aaron02/TEAM5_DOUG/Controller/readme.md

# Controller

## Links

Text to MP3: https://voicegenerator.io/
