aaron02/TEAM5_DOUG/Controller/HW/Render/3d.png

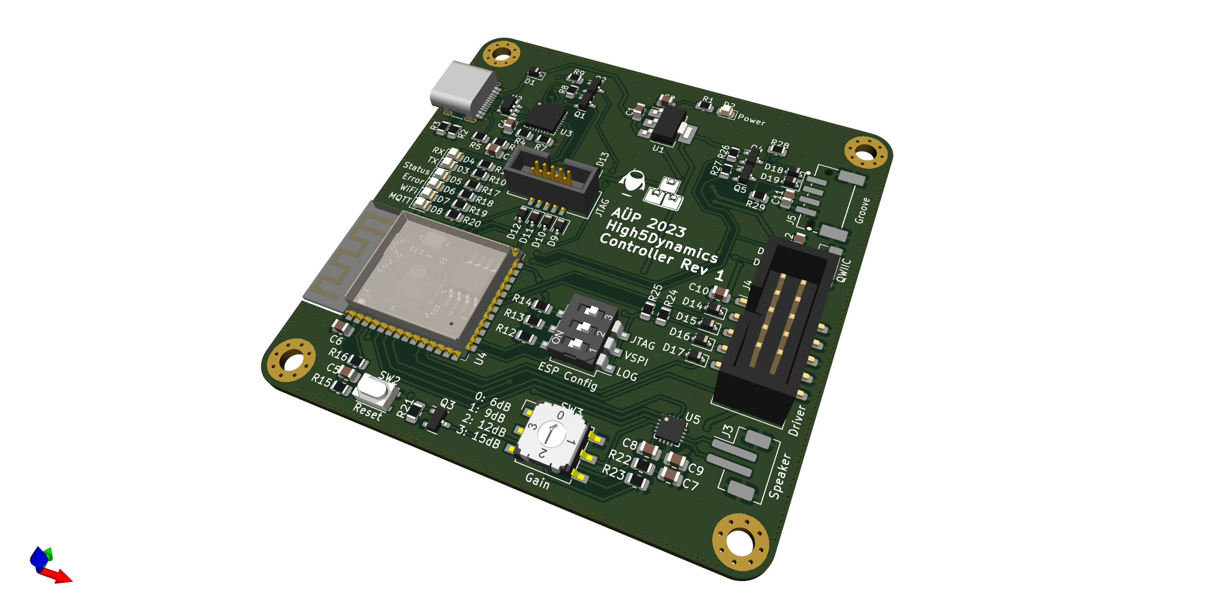
Controller/HW/Render/3d.png
