aaron02/TEAM5_DOUG/Controller/HW/Render/Render.png

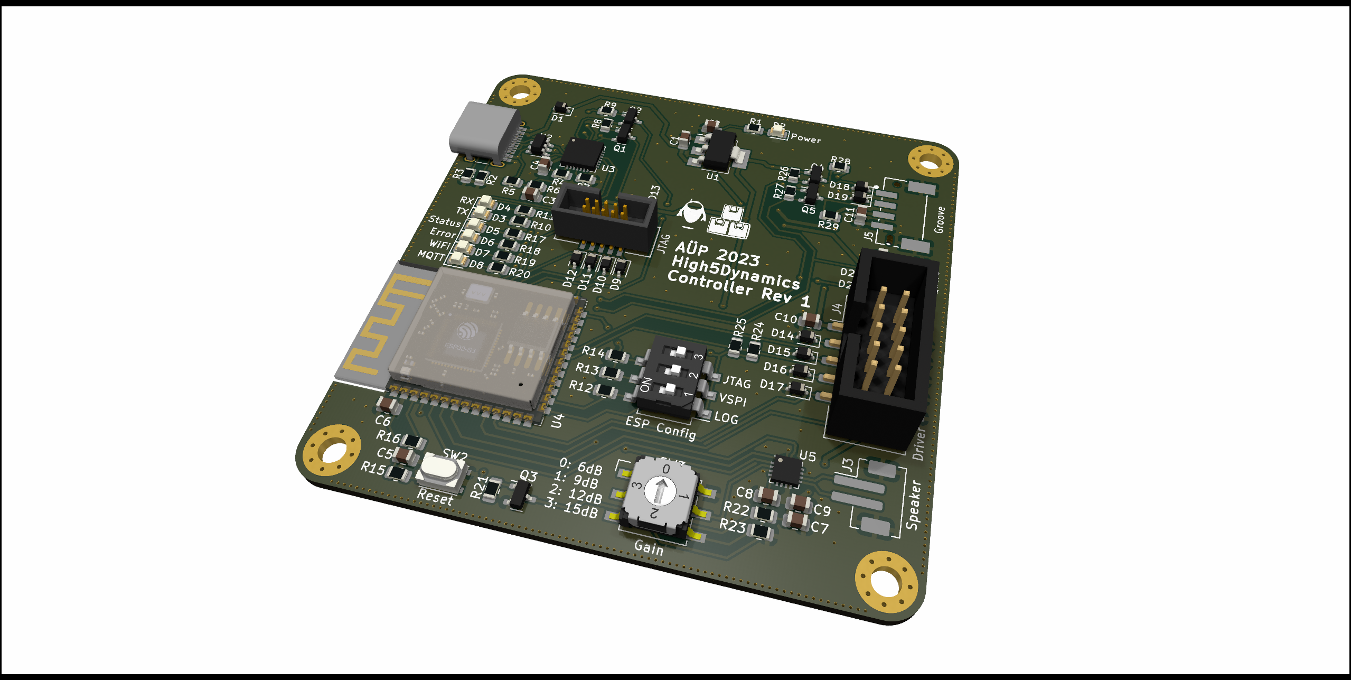
Controller/HW/Render/Render.png
