aaron02/TEAM5_DOUG/Controller/HW/BOM/BOM.xlsx

Reference | Value | DigiKey | Qty
J1 | USB |  | 1
SW2 | Reset |  | 1
J4 | Driver | 1175-1621-ND | 1
J2 | JTAG | 1175-1629-ND | 1
C5 | 1u | 1276-1026-1-ND | 1
C1, C2, C4, C6, C7 | 10u | 1276-1096-1-ND | 5
C3, C8-C12 | 100n | 1276-2449-1-ND | 6
Q4, Q5 | NX138AK | 1727-2731-1-ND | 2
Q1-Q3 | MMBT3904 | 1727-4044-1-ND | 3
U4 | ESP32-S3-WROOM-1 | 1965-ESP32-S3-WROOM-1-N8CT-ND | 1
SW1 | ESP Config | 2223-DS04-254-2-03BK-SMT-ND | 1
R6 | 47.5k | 311-47.5KCRCT-ND | 1
U3 | CP2102N-Axx-xQFN28 | 336-5890-1-ND | 1
J6 | QWIIC | 455-1790-1-ND | 1
J5 | Groove | 455-2639-1-ND | 1
J3 | Speaker | 455-2872-1-ND | 1
D6 | Error | 475-1278-1-ND | 1
D3 | TX | 475-1410-1-ND | 1
D4 | RX | 475-1410-1-ND | 1
D5 | Status | 475-1410-1-ND | 1
D7 | WiFi | 475-1410-1-ND | 1
D8 | MQTT | 475-1410-1-ND | 1
D2 | Power | 475-2488-1-ND | 1
U2 | USBLC6-2SC6 | 497-5235-1-ND | 1
SW3 | Gain | 563-1217-1-ND | 1
U1 | AP1117-33 | AZ1117IH-3.3TRG1DICT-ND | 1
R1, R4, R10, R11, R15, R17-R20 | 1k | CR0805-FX-1001ELFCT-ND | 9
R7-R9, R12-R14, R16, R21, R22, R24-R29 | 10k | CR0805-FX-1002ELFCT-ND | 15
R23 | 100k | CR0805-FX-1003ELFCT-ND | 1
R5 | 22.1k | CR0805-FX-2212ELFCT-ND | 1
R2, R3 | 5.1k | CR0805-FX-5101ELFCT-ND | 2
D9-D12, D14-D21 | D1213A | D1213A-01WS-7DICT-ND | 12
U5 | MAX98357A | MAX98357AETE+TCT-ND | 1
D1, D13 | NSR0320 | NSR0320MW2T3GOSCT-ND | 2
