aaron02/TEAM5_DOUG/Driver/HW/PDF/Driver.pdf

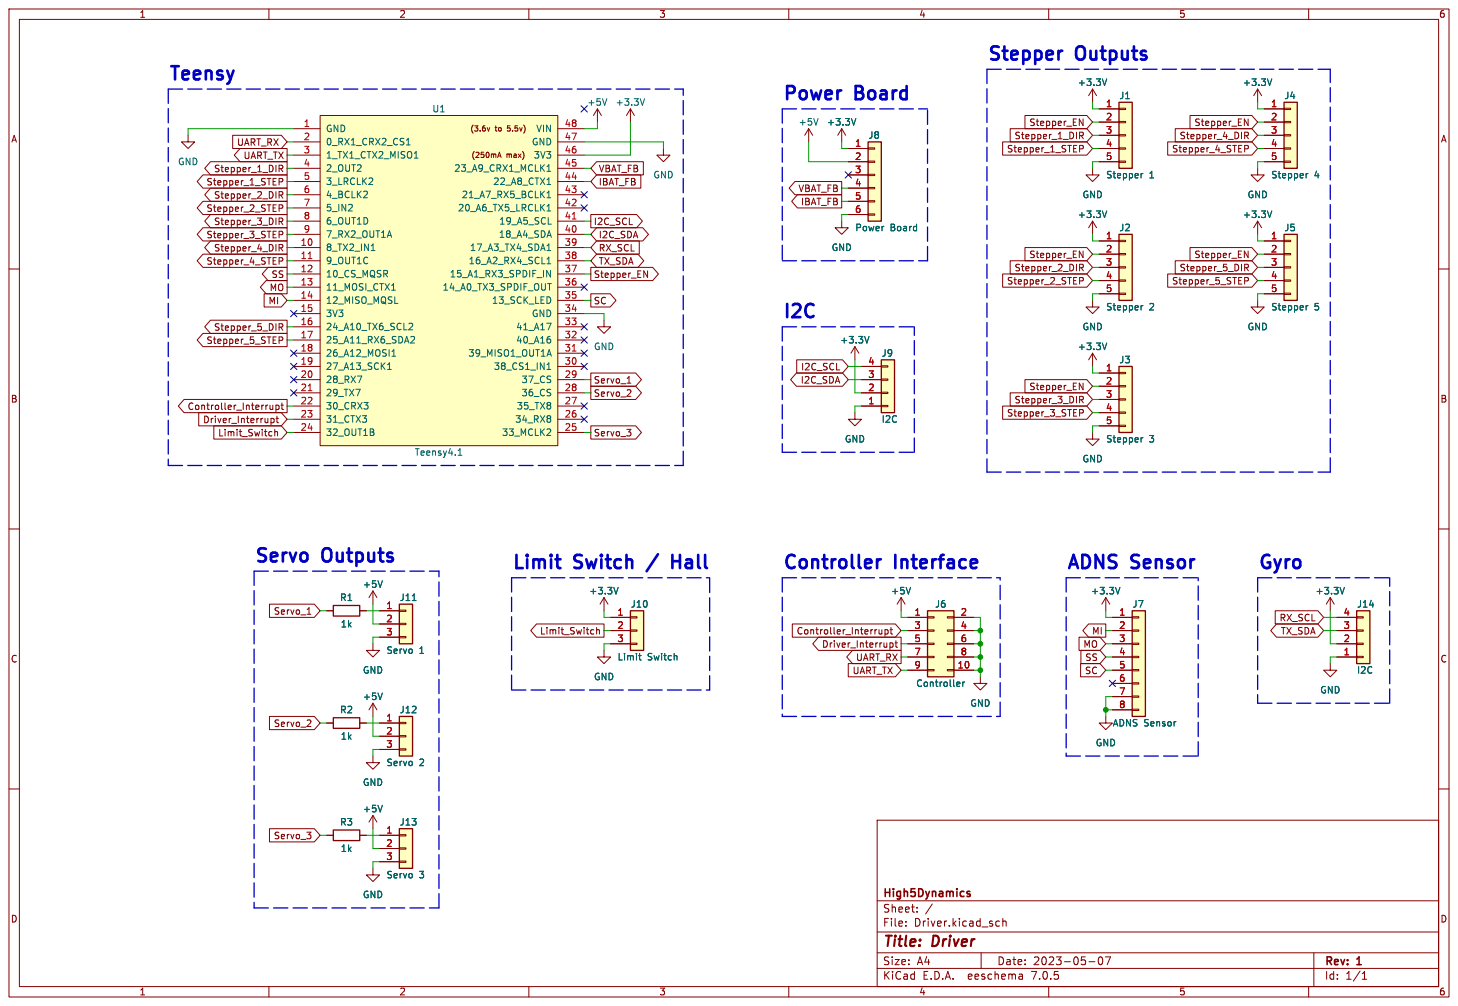
[picture p3: page 1]

Id: 1/1 Title: Driver File: Driver.kicad_sch Sheet: / High5Dynamics
