aaron02/TEAM5_DOUG/Controller/HW/PDF/Controller.pdf

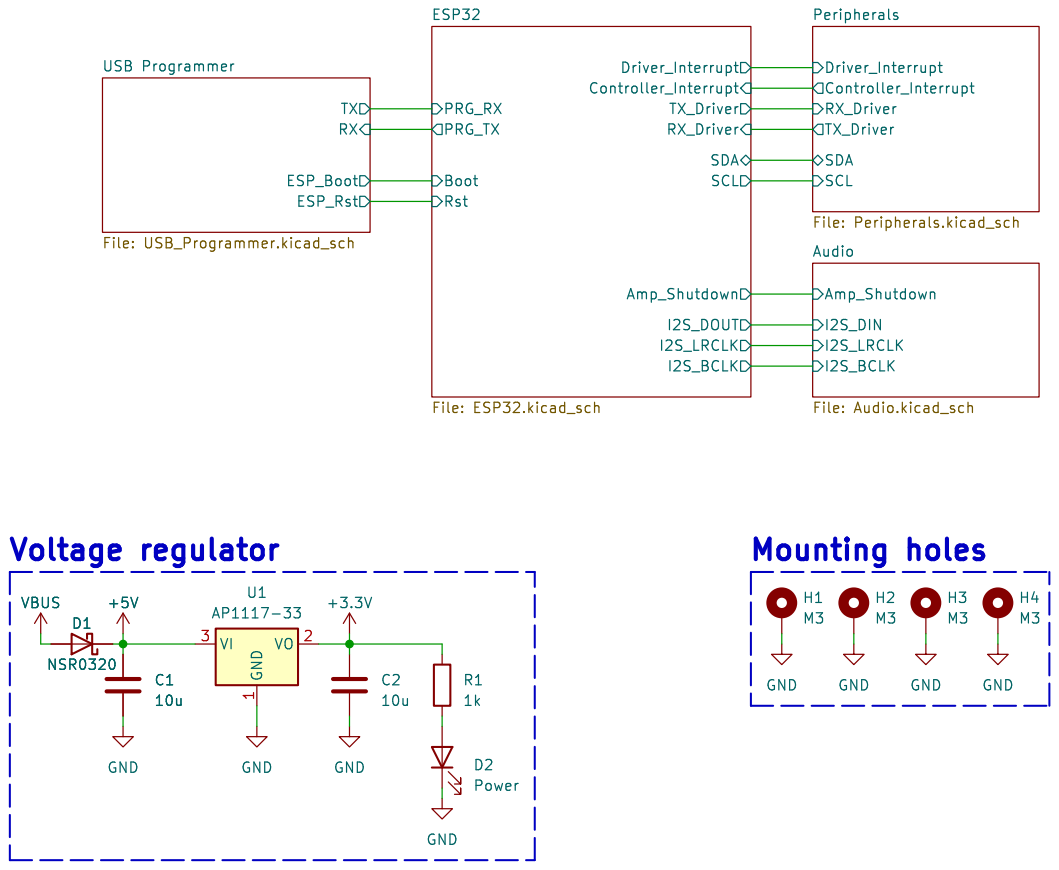
[picture p4: page 1]

Peripherals File: Peripherals.kicad_sch SCL RX_Driver TX_Driver Boot Rst PRG_TX
Audio File: Audio.kicad_sch TX_Driver RX_Driver SCL SDA Controller_Interrupt

Id: 1/5 Title: Controller File: Controller.kicad_sch Sheet: / High5Dynamics

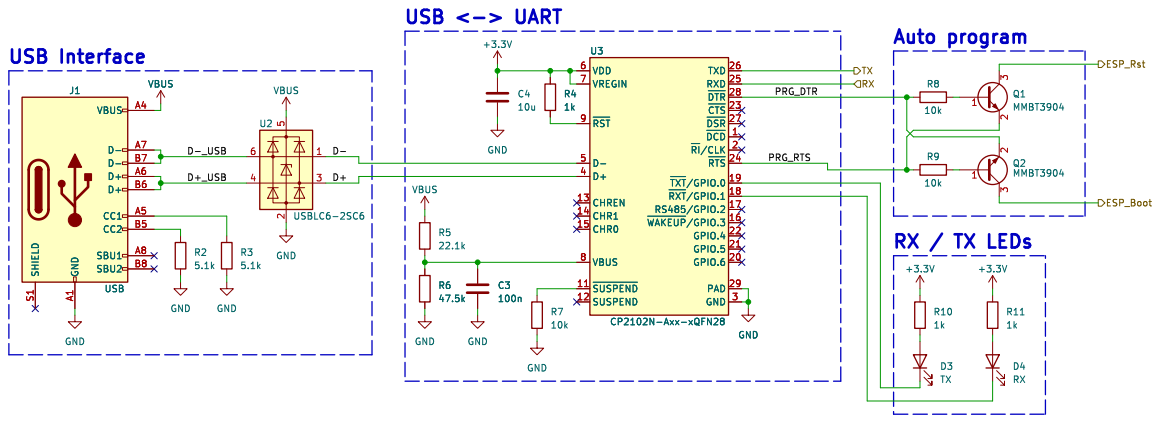
[picture p5: page 2]

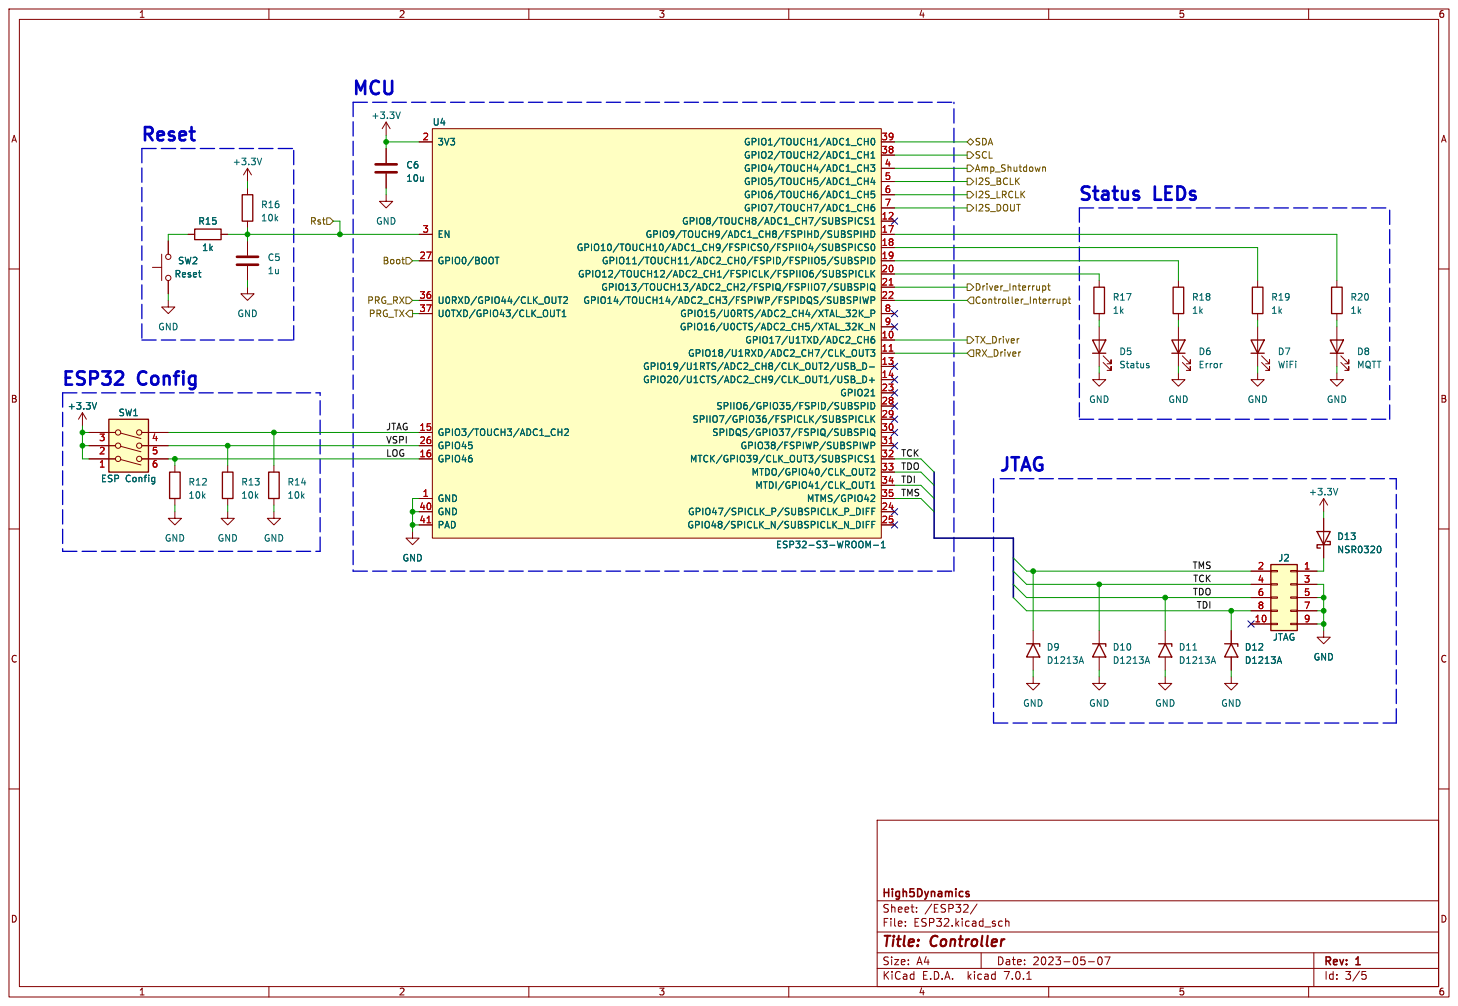
[picture p6: page 3]

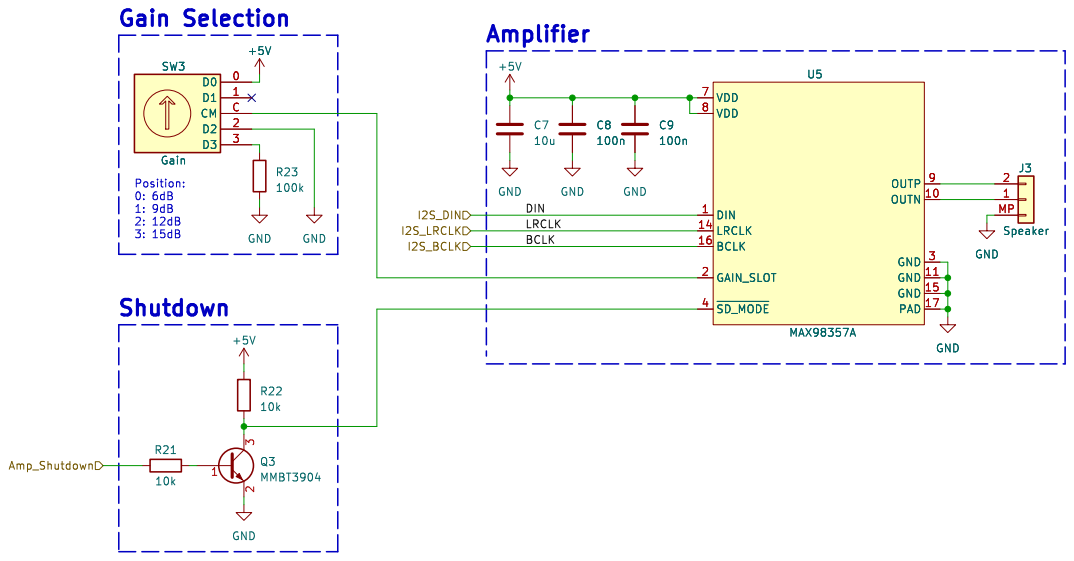
[picture p7: page 4]

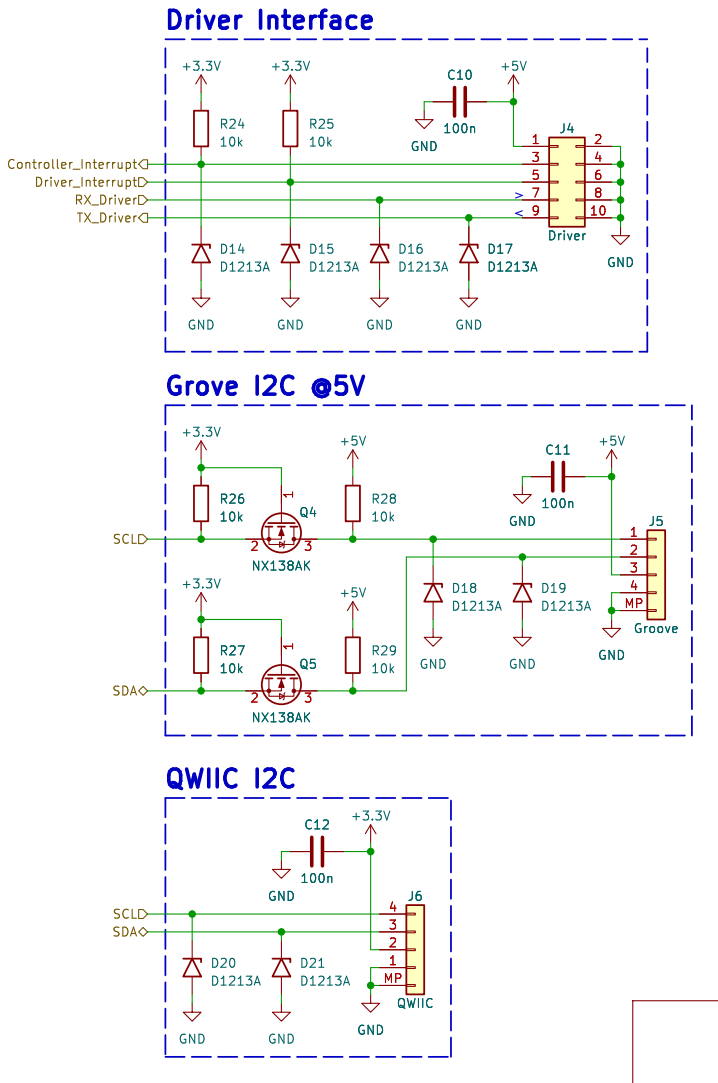
[picture p8: page 5]
