aaron02/TEAM5_DOUG/(commit log)

2023-04-20 Odimetry Korrektur und Board auf Teensy geändert.
2023-04-22 Programmanpassung für neue IO Pins, Multirthrearding Libary um Motoren in einer Seperaten Loop laufen zu lassen
2023-04-22 Added Power Distributiuon Board for Voltage and Current Sensing
2023-04-26 Create API-Definition Driver.md
2023-04-27 KiCad Projekt hinzugefügt
    [Audio.kicad_sch, Controller.kicad_pcb, Controller.kicad_sch, ESP32.kicad_sch, Peripherals.kicad_sch, USB_Programmer.kicad_sch, untitled.kicad_sch]
2023-04-27 moved gitignore for KiCad
2023-04-27 remove files using KiCad gitignore file
2023-04-27 Update API-Definition Driver.md
2023-04-29 korrektur der Odometry und Gyro vorrübergehend ausgeschaltet.
2023-04-29 PCB Zwischenstand
    [Audio.kicad_sch, Controller.kicad_pcb, Controller.kicad_sch, ESP32.kicad_sch, Peripherals.kicad_sch, USB_Programmer.kicad_sch]
2023-04-30 Controller Rev 1 PCB fertig
    [Audio.kicad_sch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]
2023-04-30 BOM update
    [Audio.kicad_sch, BOM.xlsx, Controller BOM.csv, Controller.kicad_pcb, Controller.kicad_sch, ESP32.kicad_sch, Peripherals.kicad_sch, USB_Programmer.kicad_sch]
2023-05-06 Korrektur der Strommessung
2023-05-06 Created KiCad Project for driver
    [Driver.kicad_pcb, Driver.kicad_sch]
2023-05-07 Driver Schema komplettiert
    [Driver.kicad_sch]
2023-05-07 Schemas aktualisiert mit PDF
    [Audio.kicad_sch, Controller.kicad_sch, Driver.kicad_sch, ESP32.kicad_sch, Peripherals.kicad_sch, USB_Programmer.kicad_sch]
2023-05-07 Programm Korrektur und Testfahrt akitiviert
2023-05-10 Gyro Programmierung korrigiert zu BNO 085 Debug variabeln hinzugefügt
    [Defnies.h, DriveTrain.h, Gyro.cpp, Gyro.h, Navigation.cpp, Navigation.h, main.cpp]
2023-05-11 Aufteilung des Programmes, Gyro korrekt eingebunden
2023-05-13 Korrektur des Sensoroffsets
2023-05-26 Greiffer Programm
    Greifer.h und Greifer.cpp erstellt und mit Basisfunktionen gespickt
2023-05-27 Funktion bei Greifer Hinzugefügt
    Grundstellung Funktion erstellt. Wird immer beim Aufrufen des Greifer.h ausgeführt. Bei Greifer.h diverse Positionen definiert.
2023-05-27 Kommunikation getestet und funktionstüchtig
2023-05-28 Fahren nach Position eingebunden und Compilierfehler ausgemertzt
2023-05-28 Korrektur POsition reached und Communications angepasst
2023-05-28 Power Board Limit Battery pct to 100
2023-05-28 GS angepasst
    Sollte so nun die Komplette Schrittkette durchlaufen.
2023-06-01 Place and Pick Package
    Sind fertig, nur Abstandssensor zur genauen Position anfahren fehlt. Müssten wir noch mit der Funktion mNavigation->setSollPosition(); kombinieren
2023-06-01 PlacePackage case 202 falscher Name
    richtigen namen gegeben
2023-06-02 Roboter Automatisch drehen damit die Fahrtrichtung der Grössten Distanz Entspricht
2023-06-02 Kommunikation und Greiffer Angeppast
    mit Aaron änderungen vorgenommen
2023-06-04 gyro kommunikation angepasst
2023-06-10 Schema Angepasst
    [Driver.kicad_sch]
2023-06-12 Updated PDF
    [Driver.kicad_sch]
2023-06-15 I2C mit M5Stack
    Library macht noch Probleme
    [i2cTOF.cpp, i2cTOF.h]
2023-06-17 TOF-Sensor und Hub eingebunden Distanzwerte werden ausgegeben und sind Korrekt
2023-06-18 Arm state wird beim init robot abgefragt
2023-06-18 Funktion zur berechnung der Startposition
2023-06-19 Maussensor neu kalibriert und mindestgeschwindigkeiten angepasst
2023-06-22 Drive, Geschwindigkeit und Toleranzen angepasst
2023-06-25 schalter zum übernehmen der position eingebunden
2023-06-25 gyro runden
